burbon04/TIPC_keyboard_interface/(commit log)

2026-01-26 initial commit / file as attached in https://forums.atariage.com/topic/387601-tipc-keyboard-interface-converter/
2026-02-28 v2.00, bugfixes and RTC support
    [TIPC_keyboard_interface.ino]
2026-07-08 forgot the two resistors
2026-09-22 v2.01 - bugfix tilde sign on US keyboard
    [TIPC_keyboard_interface.ino]
